JackYeul/TVC-Model-Rocket/README.md

# TVC-Model-Rocket
Repository for the simulation, design, and programming of a thrust vector controlled model rocket
