JackYeul/TVC-Model-Rocket/docs/requirements/documents/SYS.html

# Test document for development of Doorstop

# 1.0 SYS001

The launch vehicle shall maintain its attitude within +/- 5 deg of the commanded vertical reference throughout powered ascent, from motor ignition until burnout.

Parent links: MIS001

Attribute | Value
source | MIS001
verification_status | not_started

## 1.1 SYS002

The TVC model rocket shall be physically controlled via a gimbal mechanism.

Parent links: MIS001

Child links: SUB002

Attribute | Value
source | MIS001
verification_status | not_started

## 1.2 SYS003

There shall be an avionics system onboard the TVC model rocket that supplies power, logic capabilities, sensors, and recovery electronics.

Parent links: MIS001

Attribute | Value
verification_status | not_started

## 1.3 SYS004

The TVC model rocket shall have a recovery system that lowers it to the ground safely.

Parent links: MIS001

Attribute | Value
verification_status | not_started

## 1.4 SYS005

The TVC model rocket shall have an airframe capable of holding all necessary systems while withstanding loads from aerodynamic forces, motor thrust, and recovery system deployment.

Parent links: MIS001

Attribute | Value
verification_status | not_started

## 1.5 SYS006

The TVC model rocket shall have a GNC system capable of maintaining stable vertical flight.

Parent links: MIS001

Attribute | Value
verification_status | not_started
