JackYeul/TVC-Model-Rocket/docs/requirements/documents/MIS.html

# Test document for development of Doorstop

# 1.0 MIS001

The stakeholder needs a flight-demonstrable model rocket that uses active thrust vector control (TVC) to maintain a stable, near-vertical ascent under its own closed-loop attitude control, so that the TVC design approach can be validated on a low-cost airframe before being applied to larger vehicles.

Child links: SYS001, SYS002, SYS003, SYS004, SYS005, SYS006

Attribute | Value
source | Stakeholder need - project sponsor flight demonstration objective
verification_status | not_started
