JackYeul/TVC-Model-Rocket/docs/requirements/traceability.csv

MIS | SYS | SUB | CMP
MIS001 | SYS001
MIS001 | SYS002 | SUB002
MIS001 | SYS003
MIS001 | SYS004
MIS001 | SYS005
MIS001 | SYS006
