JackYeul/TVC-Model-Rocket/Hardware/Avionics/Flight Computer/KiCADv6/IND_TAIYO_NRS8040_TAY.step

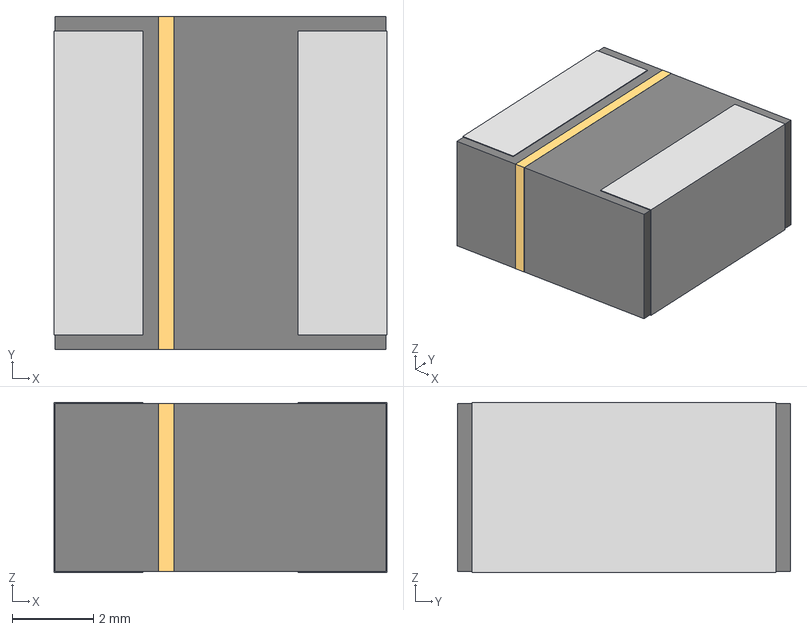
[picture p1: CAD file, 2026-10-03]
Hardware/Avionics/Flight Computer/KiCADv6/IND_TAIYO_NRS8040_TAY.step
8.20 x 8.21 x 4.19 mm
