JackYeul/TVC-Model-Rocket/Hardware/Avionics/Flight Computer/SOIC-8_NB_ONS.step

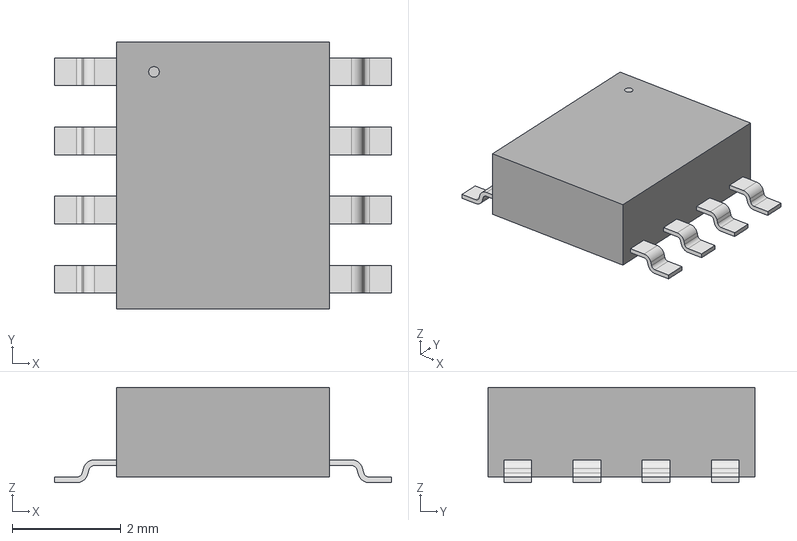
[picture p2: CAD file, 2026-10-01]
Hardware/Avionics/Flight Computer/SOIC-8_NB_ONS.step
6.20 x 4.90 x 1.75 mm
