JackYeul/TVC-Model-Rocket/Hardware/Configuration 1.step

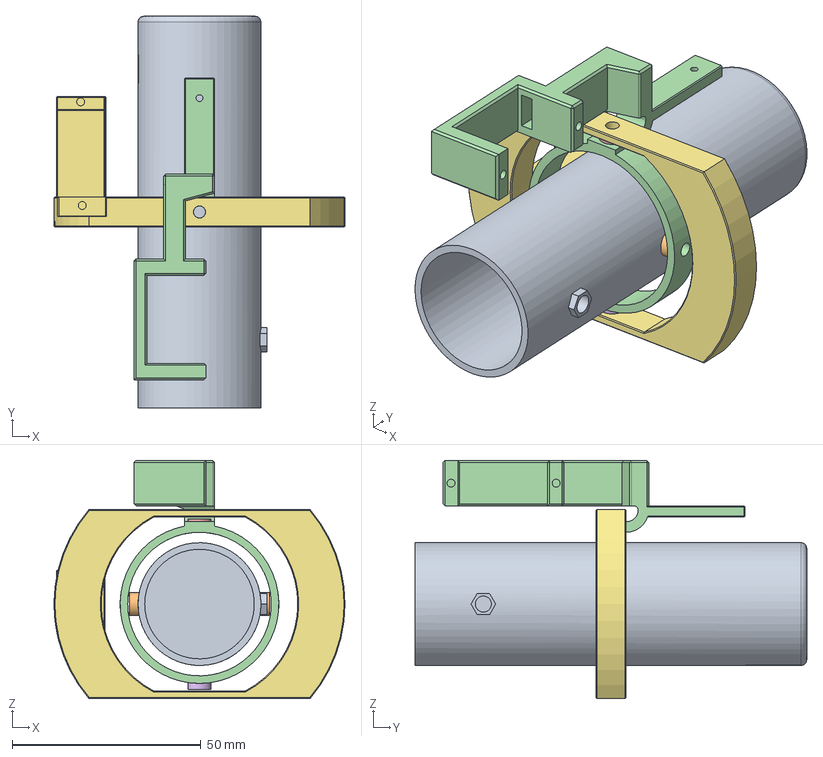
[picture p3: CAD file, 2026-09-18]
Hardware/Configuration 1.step
77.0 x 103.6 x 63.0 mm
