JackYeul/TVC-Model-Rocket/Hardware/Avionics/Flight Computer/KiCADv6/CAP_YX_5X11_RUB.step

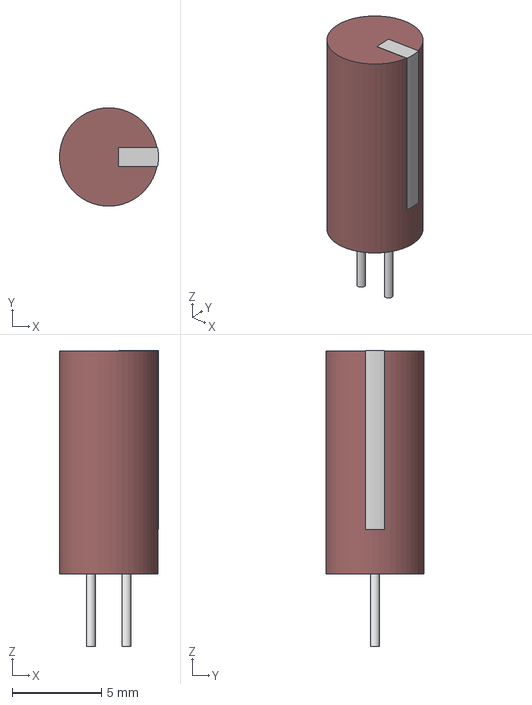
[picture p4: CAD file, 2026-10-03]
Hardware/Avionics/Flight Computer/KiCADv6/CAP_YX_5X11_RUB.step
5.55 x 5.51 x 16.6 mm
