JackYeul/TVC-Model-Rocket/Hardware/Avionics/Flight Computer/KiCADv6/SDO_MBRS120T3G_OSI.step

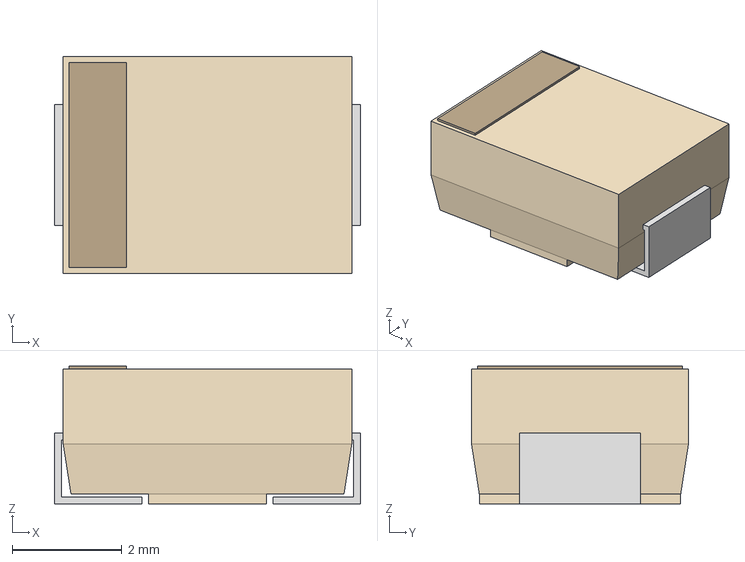
[picture p5: CAD file, 2026-10-01]
Hardware/Avionics/Flight Computer/KiCADv6/SDO_MBRS120T3G_OSI.step
5.59 x 3.96 x 2.52 mm
