JackYeul/TVC-Model-Rocket/(list of files, cad)

Other CAD files:
Hardware/Configuration 1.f3z
