JackYeul/TVC-Model-Rocket/(commit log)

2026-09-18 uploaded fusion files
    [Configuration 1.f3z, Configuration 1.step]
2026-09-18 Add Doorstop requirements skeleton
    Four-tier document tree under requirements/: mission (MIS) -> system
    (SYS) -> subsystem (SUB) -> component (CMP). Each document carries
    custom source and verification_status attributes, and one example
    requirement per tier is linked into a complete thread from MIS001
    down to CMP001.
2026-09-18 Add .gitattributes to stabilize line endings
    KiCad and MATLAB text files are normalized to LF in the repository, and
    CAD/archive files are marked binary. Without this, a save on one machine
    could rewrite every line of a file, producing phantom whole-file diffs
    that surface as merge conflicts.
    Existing files are left as-is; they normalize as they are next modified.
2026-09-18 moved kicad files to flight computer folder
    [Barometer.kicad_sch, IMU.kicad_sch, Jack_Yeulenski_Flight_Computer.csv, Jack_Yeulenski_Flight_Computer.kicad_pcb, Jack_Yeulenski_Flight_Computer.kicad_sch]
2026-09-24 added doorstop high level tree
    [traceability.csv]
2026-09-28 PCB updates
    [Barometer.kicad_sch, IMU.kicad_sch, Jack_Yeulenski_Flight_Computer.kicad_pcb, Jack_Yeulenski_Flight_Computer.kicad_sch]
2026-10-01 updated FC
    [Barometer.kicad_sch, IMU.kicad_sch, Jack_Yeulenski_Flight_Computer.kicad_pcb, Jack_Yeulenski_Flight_Computer.kicad_sch, SDO_MBRS120T3G_OSI.step, SOIC-8_NB_ONS.step]
2026-10-03 Final updates
    [Barometer.kicad_sch, CAP_YX_5X11_RUB.step, IMU.kicad_sch, IND_TAIYO_NRS8040_TAY.step, Jack_Yeulenski_Flight_Computer.kicad_pcb, Jack_Yeulenski_Flight_Computer.kicad_sch]
2026-10-03 final touches
    [Jack_Yeulenski_Flight_Computer-B_Cu.gbr, Jack_Yeulenski_Flight_Computer-B_Mask.gbr, Jack_Yeulenski_Flight_Computer-B_Paste.gbr, Jack_Yeulenski_Flight_Computer-B_Silkscreen.gbr, Jack_Yeulenski_Flight_Computer-Edge_Cuts.gbr, Jack_Yeulenski_Flight_Computer-F_Cu.gbr, Jack_Yeulenski_Flight_Computer-F_Mask.gbr, Jack_Yeulenski_Flight_Computer-F_Paste.gbr]
2026-10-07 Prototype Design
    [Barometer.kicad_sch, IMU.kicad_sch, Jack_Yeulenski_Flight_Computer.kicad_pcb, Jack_Yeulenski_Flight_Computer.kicad_sch, Jack_Yeulenski_L1FC.csv]
